hollystill/LowCostGNSS/Hardware/README.md

# Low-cost GNSS hardware

### Table 1. Components to build a low-cost GNSS unit.

| Component | Description | Part number | Cost (NZD)  |
|---|---|---|---|
| [U-blox ZED-F9P receiver board](https://gnss.store/zed-f9p-gnss-modules/99-13-elt0087.html#/27-add_antenna-without_antenna) | GNSS receiver | ELT0087 | $382.22 NZD |
| [U-blox ANN-MB multi-band (L1, L2/E5b) 28dB patch antenna](https://www.u-blox.com/en/product/ann-mb-series) | Antenna option 1 |  ANN-MB-00 | $103.32 NZD |
| [L1/L2/L5 multi-band 38dB survey antenna](https://gnss.store/gnss-rtk-multiband-antennas/140-elt0123.html)  | Antenna option 2 |  ELT0123 | $345.84 NZD |
| [Adafruit Feather M0 Adalogger](https://www.adafruit.com/product/2796) | Data acquisition |  2796 | $34.35 NZD  |
| [FeatherWing Proto Board](https://www.adafruit.com/product/2884) | Data acquisition |  2884 | $8.53 NZD |
| [Socket board header kit 12+16pin](https://www.adafruit.com/product/2886) | Data acquisition |  2886 | $1.64 NZD |
| [Stacking header kit 12+16 pin](https://www.adafruit.com/product/2830) | Data acquisition |  2830 | $2.15 NZD |
| [32 GB micro SD card](https://www.ascent.co.nz/productspecification.aspx?itemID=452529) | Data acquisition |  452529 | $11.81 NZD  |
| [Molex connector 2 pin](https://www.jaycar.co.nz/2-pin-0-1in-header-with-crimp-pins-2-54mm-pitch/p/HM3402) | For circuit board |  HP0720 | $1.10 NZD |
| [Molex connector 4 pin](https://www.jaycar.co.nz/4-pin-0-1in-header-with-crimp-pins-2-54mm-pitch/p/HM3404?)| For circuit board |  HP0724 | $1.30 NZD |
| [Temperature stable resistors x2](https://nz.rs-online.com/web/p/through-hole-resistors/7550713) | For circuit board |  755-0713 | $1.48 NZD |
| [12 pin JST wire assembly](https://gnss.store/cable-connectors/18-ELT0004.html) | Cable |  ELT0004 | $9.65 NZD |
| [12v SLA battery 18Ahr](https://www.jaycar.co.nz/12v-18ah-sla-battery/p/SB2490) | Battery |  SB2490 | $129 NZD |
| [Ring terminals](https://www.jaycar.co.nz/eye-terminal-yellow-pack-of-8/p/PT4714) | Battery |  PT4714 | $1.00 NZD |
| [100 watt solar panel x2 with controller](https://www.aliexpress.com/item/1005004121593648.html) | Solar panel |  SB2490 | $27 NZD |
| [PWM solar charge controller](https://www.aliexpress.com/item/1005003634186508.html) | Solar controller |  - | $9.41 NZD |
| [USB power cable 0.25 m](https://www.aliexpress.com/item/32958208619.html) | Power cable |  - | $0.86 NZD |
| [Silicone solar power cable 1 m](https://www.aliexpress.com/item/4000625095039.html) | Power cable |  - | $2.41 NZD |
| [DC barrel connector Y-cable](https://www.aliexpress.com/item/4000533388911.html) | Power cable |  Q22031 | $1.85 NZD |
| [5A blade fuse](https://www.jaycar.co.nz/5a-tan-standard-blade-fuse/p/SF2130) | Circuit protection |  SF2130 | $1.50 NZD |
| [Blade fuse holder](https://www.jaycar.co.nz/30a-32vdc-inline-standard-blade-fuse-holder/p/SZ2040)  | Circuit protection |  SZ2040 | $6.20 NZD |
| [ABS instrument case](https://www.jaycar.co.nz/abs-instrument-case-with-purge-valve-mpv2/p/HB6381)  | Snow-proof casing |  HB6381 | $119.00 NZD |
| [PG7 cable gland](https://www.jaycar.co.nz/3-6-5mm-dia-waterproof-cable-glands-pack-of-2/p/HP0720)  | Snow-proof casing |  HP0720 | $8.20 NZD |
| [PG9 cable gland](https://www.jaycar.co.nz/4-8mm-dia-waterproof-cable-glands-pack-of-2/p/HP0724) | Snow-proof casing |  HP0724 | $9.50 NZD |
| [Cable end ferrules](https://www.aliexpress.com/item/33040940850.html) | Cabling |  E1508 | $0.25 NZD |
| | |  Total cost: | $873.73 NZD |
| | | | $480.06 EUR |

Prices current as of October 2023.
