hollystill/LowCostGNSS/Documentation/Images/ublox_receiver.jpg

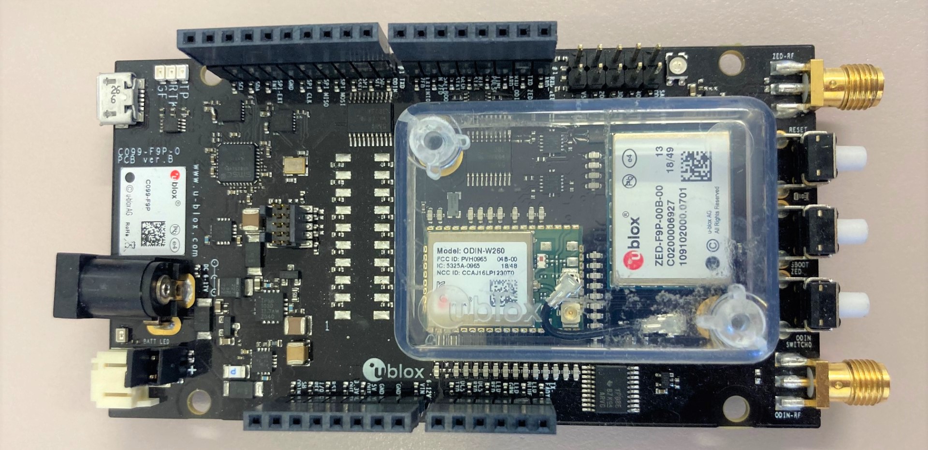
Documentation/Images/ublox_receiver.jpg
