hollystill/LowCostGNSS/(commit log)

2023-11-01 Update .config file
    [config.txt]
2023-12-04 Add/delete files
    [config.txt]
