hollystill/LowCostGNSS/(notices)

Notices in the files:
Software/Data-logger/uBlox_PPP_logger.ino:
This program is free software licensed under the GPL (>=v3).
Read the GPL-3.txt file that comes with this code for details.
Dependencies: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
